stefanodemartini/flylineprofiler/(commit log)

2026-02-20 working start/stop motor
2026-02-20 Refactor UART parsing
2026-02-27 Fix: stream CSV export to avoid ESP32 freeze
    [master.ino]
2026-02-27 Fix: stream CSV export to avoid ESP32 freeze. Added
    [master.ino]
2026-03-04 Added timer, modified chart graphics
2026-04-17 Add WPF desktop app, update firmware v0.3.0, add .gitignore and Copilot instructions
    - master.ino v0.3.0: GOTOPOS, dynamic speed, scan autostop, WiFiManager
    - slave.ino v0.3.0: GOTOPOS with quadratic deceleration, UART protocol
    - app/: WPF desktop client (MVVM, WebSocket, ScottPlot placeholder)
    - .gitignore: exclude bin/obj and VS artifacts
    - .github/copilot-instructions.md: architecture and conventions docs
2026-04-17 Fix all WPF app gaps vs web UI
    Bugs fixed:
    - scan_on/scan_off commands were sent as 'scanon'/'scanoff' (firmware ignored them)
    - 'params' message: displayZero/offset not parsed or displayed; now shown in status panel
    - Existing point update did not trigger CollectionChanged; plot never refreshed (use remove+add)
    - 'scan_enabled' message: ScanReceiving state not tracked; buttons not reflecting scan state
    - 'goto_status': IsGoToActive not tracked; motor/scan/goto buttons not disabled during GOTOPOS
    Features added:
    - Load full history from HTTP /export on every WebSocket connect (batch, single plot refresh)
    - Auto-reconnect after disconnect (ReconnectSeconds from settings, cancellable on manua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
2026-04-17 fix: resolve 15 firmware bugs in master.ino and slave.ino
    master.ino:
    - FW-01: add microsecond timeouts to readCaliper() and decodeCaliperReadings()
    spin-loops — prevents infinite hang when caliper is off or disconnected
    - FW-04: addDataPoint() update path now stores EMA-smoothed diameter
    (newPoint->diameter) instead of raw value — fixes EMA state corruption
    - FW-07: goToPosition() sends targetCm+2 to slave to compensate for the
    (encoder/30)-2 coordinate offset — fixes 2 cm systematic positioning error
    - FW-08: goToPosition() early-returns when isGoToActive — prevents re-entrant
    WebSocket call from overwriting oldScanState and losing scan enable state
    - FW-09: loop() takes on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
    [master.ino, slave.ino]
2026-04-17 fix: broadcast scan_enabled:false when GOTOPOS starts
    Clients now receive a scan_enabled:false event the moment goToPosition()
    suspends scanning, making the protocol symmetric with the scan_enabled
    restore broadcast already sent on GOTOPOS completion or abort.
    [master.ino]
2026-04-17 fix: restore missing # on #include <WiFi.h>
    [master.ino]
2026-04-17 fix: increase caliper timeout from 500us to 10ms per clock phase
    The original 500 us timeout was shorter than the actual caliper clock
    half-period (many cheap calipers run at ~500 Hz = ~1 ms per phase),
    causing decodeCaliperReadings() to bail on every bit and leave
    lineDiameter permanently at 0.
    New values: 10 ms per bit phase (handles any caliper down to 50 Hz),
    500 ms for the inter-packet HIGH gap.
    [master.ino]
2026-04-17 revert: restore original caliper spin-loops (FW-01 reverted)
    Timeout-based approach was breaking caliper reads because the actual
    clock half-period of this caliper is unknown and exceeds any generic
    timeout value. The hardware watchdog (default ~1s) provides a safety
    net on disconnect. A proper fix requires ISR-driven caliper reading
    which can be addressed in a future iteration.
    [master.ino]
2026-04-17 fix: replace blocking caliper reader with interrupt-driven ISR (FW-01)
    onCaliperChange() (IRAM_ATTR, CHANGE on CALIPER_CLOCK_PIN) mirrors the
    original logic entirely in interrupt context:
    - Rising edge → record timestamp
    - Falling edge → measure HIGH duration; if >500 µs = inter-packet gap,
    commit the 24-bit word (calRawValue/calSign/calDataReady)
    and reset accumulators; then read the data bit
    readCaliper() is now non-blocking: noInterrupts() + copy latest decoded
    value from ISR state + clear calDataReady. loop() is never blocked.
    readCaliperAverage() waits for up to 2 s for N fresh ISR packets instead
    of calling the old blocking spin loop.
    This als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
    [master.ino]
2026-04-17 fix: correct caliper unit conversion from /100 to /200
    The caliper protocol encodes values in units of 0.005 mm per LSB.
    The old blocking loop accidentally skipped bit-0 (the LSB) due to
    its wait-for-rising-then-falling structure, halving the raw count.
    rawCount/2 / 100 = correct mm value.
    The ISR reads all 24 bits correctly, so dividing by 100 gave 2x the
    true measurement. Dividing by 200 restores the correct output.
    [master.ino]
2026-04-17 fix: remove redundant JS live EMA from web UI
    Firmware already applies EMA (alpha=0.1) before sending data over
    WebSocket. The JS live EMA was double-smoothing the signal, adding
    latency and masking fast diameter changes.
    Live view now uses firmware-smoothed values directly.
    Historical chart EMA slider is unaffected.
    [master.ino]
2026-04-17 fix: make GOTOPOS encoder-driven instead of open-loop step-count
    Root cause: slave used its own step counter (from boot) to decide when
    to stop during GOTOPOS. If encoder and slave step count diverged (after
    a reset command, different PULSES_PER_CM calibration, or step slippage)
    the motor would stop at the wrong physical position, independent of
    what the encoder reported.
    Two-part fix:
    1. SYNCPOS command: master sends current encoderValue to slave before
    every GOTOPOS so slave step counter = encoder value (both in sync).
    2. Encoder-based stop in master loop: master watches encoder and sends
    STOP when |floatCm - goToTargetCm| <= 0.5cm. This is the authoritative
    completion trigger. g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
    [master.ino, slave.ino]
2026-04-17 fix: reduce coasting distance when stopping from FAST mode
    At ACCEL=1500 steps/s² and FAST_HZ=12000 steps/s the deceleration
    distance was ~16 metres (48,000 steps). This caused excessive overshoot
    after a FAST stop.
    Add FAST_STOP_DECEL=24000 steps/s² applied only when stopMotion() is
    called from FAST_S or FAST_O mode. This reduces the stop distance to
    ~1 metre (3,000 steps = ~100cm). Normal ACCEL is restored immediately
    after for subsequent SCAN/GOTOPOS moves.
    [slave.ino]
2026-04-17 feat: show position label next to each segment node
    Each node now displays a small label anchored at the node point:
    142 cm
    0.880 mm
    Label uses 9pt dark-red text with a semi-transparent white
    background so it stays readable over the scan data. Labels
    update live during drag so you can see exact coordinates while
    repositioning a node.
2026-04-17 feat: live hover readout snapping to nearest scan data point
    Move cursor over the chart and the status bar shows the exact
    measurement at that position:
    142 cm | 0.880 mm
    Works in both normal and segment-draw mode. Clears when the
    mouse leaves the chart. Reads FilteredY (EMA-smoothed value)
    from the nearest MeasurementPoint by X distance.
2026-04-17 feat: make segment node labels clearly visible
    - Font 9pt → 11pt bold
    - White near-opaque background (0.93 alpha)
    - Dark-red border 1.5px + 4px padding inside box
    - 8px pixel offset (right+up) so label clears the marker dot
2026-04-17 fix: export segment nodes only, no interpolation
    CSV now contains exactly the nodes you placed — one row per node,
    sorted by position. No per-cm interpolation.
    Lunghezza cm,Diametro mm
    34,0.880
    520,0.910
    ...
2026-04-17 feat: save and load segment nodes (session persistence)
    File > Salva nodi... — saves nodes to .nodes.csv
    File > Carica nodi... — reloads a previously saved session;
    asks confirmation before replacing existing nodes.
    The file format is the same as the export CSV, so both are
    interchangeable.
2026-04-17 feat: replace menu bar with Office-style Fluent Ribbon (Fluent.Ribbon 10)
    - Add Fluent.Ribbon NuGet package
    - Window → RibbonWindow; Menu → Ribbon with Backstage (File button)
    - Tabs: Connessione | Motore | Grafico | Segmenti
    - Command buttons removed from content area; all controls in ribbon
    - Layout simplified: Stato + GOTOPOS (row 0), Chart (row 1, fills), Log (row 2)
    - AutoFitToggle_Click / ToggleDrawMode_Click updated for ToggleButton IsChecked (bool?)
2026-04-17 fix: apply Light.Blue ribbon theme via XAML resource merge
    Merge Fluent/Themes/Themes/Light.Blue.xaml in App.xaml instead
    of calling ThemeManager at runtime — avoids the missing-theme
    crash and works correctly without any code changes.
2026-04-17 fix: remove -2cm boot offset from GOTOPOS and position display
    The arbitrary -2 offset caused:
    - display showing -2 at boot / after reset (not 0)
    - GOTOPOS needing a hidden +2 compensation in the command
    Now: reset at physical start -> display shows 0 -> GOTOPOS 2400
    stops exactly 2400 cm from your defined zero. No hidden offsets.
    Changes:
    - All four (encSnap|encoderValue)/PULSES_PER_CM: removed - 2
    - goToPosition(): removed + 2.0f from GOTOPOS cmd, updated comment
    [master.ino]
2026-04-17 fix: restore -2cm caliper offset; fix reset to show 0 at line start
    The encoder wheel is physically 20mm behind the caliper, so the
    display formula caliper_cm = encoder/30 - 2 is correct and must
    be kept. The previous commit wrongly removed it.
    The real bug was in reset: setting encoderValue=0 made the display
    show -2 after reset instead of 0. Fixed by setting
    encoderValue = 2 * PULSES_PER_CM so the caliper formula yields 0.
    Workflow:
    1. Position caliper at physical line start
    2. Press Reset -> display shows 0
    3. GOTOPOS 2400 -> caliper stops at exactly 2400 cm
    [master.ino]
2026-04-17 feat: separate Reset lunghezza and Cancella grafico
    Firmware:
    - New resetpos command: resets encoder to 0 (display shows 0)
    without clearing measurement data
    WPF ribbon:
    - Motore > Calibrazione: add Reset lunghezza (sends resetpos)
    - Grafico > Vista: add Cancella grafico (clears local chart data only)
    - Reset dati remains as the combined operation (position + data)
    [master.ino]
2026-04-17 refactor: single Azzera tutto button (zeros position + clears graph)
    Remove separate Reset lunghezza / Cancella grafico buttons.
    Single button in Motore > Calibrazione does both: sends reset
    to firmware (zeros encoder) and clears local chart data.
2026-04-17 feat: move smoothing to app, remove EMA from firmware
    - Remove EMA from addDataPoint — broadcasts raw compensated diameter
    - Remove emaStore/emaStoreInit globals
    WPF app:
    - SmoothingEnabled property in MainViewModel (default true)
    - AddLivePoint applies EMA only when SmoothingEnabled; resets EMA
    state when toggled so next point seeds a fresh filter
    - Grafico > Vista: Smoothing EMA toggle button (default ON)
    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
    [master.ino]
2026-04-17 fix: catch WebSocket disconnect exceptions in ReceiveLoopAsync
    ESP32 closes the WebSocket without the proper close handshake.
    Without catching the exception the fire-and-forget task becomes
    an unobserved exception and crashes the app via the GC finalizer.
    Catch WebSocketException, OperationCanceledException and IOException;
    Disconnected event is always fired in the finally block.
2026-05-03 feat: encoder-fed position for GOTOPOS + caliper median filter + live EMA
    - Remove SYNCPOS one-shot sync; master now streams POS:<steps> every 100ms
    during GOTOPOS so slave uses wheel encoder as sole position source
    - Slave getDistanceToGo() and checkPositionReached() use encoderFedPos
    instead of stepper->getCurrentPosition()
    - POS: updates dropped in motorQueueTx if a real command is pending
    - Add readCaliperMedian(5): collects 5 packets, returns median value,
    replacing single readCaliperDisplay() in scan loop — rejects spikes
    - JS addDataPoint() and loadHistoryFromExport() now apply smoothEMA()
    with the slider alpha before pushing to chart (live data treated same
    as imported da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
2026-05-21 v0.4.1: fix scan state desync on client connect
    Send scanEnabled state to every client on WebSocket connect so the
    Ricezione ON/OFF button always reflects the real firmware state.
    Prevents length display from updating when button shows Ricezione OFF
    after a page reload or reconnect while scan was active.
    [master.ino, slave.ino]
2026-05-22 slave v0.4.2: fix GOTOPOS motor not moving + overshoot detection
    [slave.ino]
2026-05-22 Fix GOTOPOS overshoot: physics-correct sqrt deceleration + initial encoder sync
    - slave v0.4.3: replace quadratic curve with sqrt(2*GOTOPOS_ACCEL*d*STEPS_PER_ENC) profile.
    The sqrt curve guarantees the motor can always stop exactly at target:
    at d=5 enc -> v=1225 Hz -> stopping distance=5 enc (perfect landing).
    - slave: add GOTOPOS_ACCEL=6000 Hz/s (4x SCAN) and STEPS_PER_ENC=25 constants.
    - slave: GOTOPOS handler now parses initial encoder position (4th field in command)
    and starts motor at calculateDynamicSpeed(initialDist) instead of FAST_HZ.
    This eliminates overshoot for short GOTOPOS moves (<83 cm) entirely.
    - slave: simplify checkPositionReached() stop condition to distanceToGo<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
    [master.ino, slave.ino]
2026-05-22 slave v0.4.4: simplify GOTOPOS to two-phase fastslowforceStop
    Replace physics sqrt curve with a simple two-phase approach:
    - Phase 1: run at FAST_HZ while distance > SLOW_ZONE_ENC (500 enc, ~16 cm)
    - Phase 2: drop to MIN_SPEED_HZ (300 Hz, ~0.5 cm/s) inside the slow zone
    - At target (distanceToGo <= 5): call forceStop() for instant stop with zero coast
    forceStop() is safe at 300 Hz because the motor has negligible kinetic energy.
    Removes GOTOPOS_ACCEL and STEPS_PER_ENC constants (no longer needed).
    [slave.ino]
2026-05-22 slave v0.4.5: fix slow-zone transition use FAST_STOP_DECEL for FASTSLOW brake
    Root cause of v0.4.4 failure: ACCEL=1500 Hz/s takes ~62 cm to brake from
    FAST_HZ(12000) to MIN_SPEED_HZ(300). The 500 enc slow zone was only ~16 cm,
    so the motor was still going ~9000 Hz when it hit the target same overshoot.
    Fix: when entering the slow zone, setAcceleration(FAST_STOP_DECEL=24000) before
    setSpeedInHz(MIN_SPEED_HZ). At 24000 Hz/s the brake takes ~120 enc (~4 cm),
    leaving ~80 enc of genuine crawl before forceStop() fires at 5 enc.
    Also reduce SLOW_ZONE_ENC from 500 to 200 (200 enc > 120 enc brake dist = safe margin).
    Restore ACCEL after forceStop() for subsequent SCAN moves.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
    [slave.ino]
2026-05-22 slave v0.4.6: fix stopMotion() for GOTOPOS use forceStop() not stopMove()
    Root cause of all GOTOPOS overshoot: stopMotion() called stopMove() then
    immediately setAcceleration(ACCEL=1500). FastAccelStepper applies setAcceleration()
    to the ONGOING deceleration, overriding any FAST_STOP_DECEL set earlier.
    Result: motor always decelerates at 1500 Hz/s from 12000 Hz = 64 cm of coast.
    Fix: for GOTOPOS mode, use forceStop() which stops the motor with no decel ramp.
    Step loss is acceptable because the encoder (not step counter) is the position
    reference. The slow-zone logic (FAST_STOP_DECEL + MIN_SPEED_HZ) still runs and
    will reduce speed before the stop, making forceStop() mechanically gentle.
    C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
    [slave.ino]
2026-05-22 slave v0.4.7: GOTOPOS linear speed ramp over last 33 cm
    Replace two-phase (fast/slow) with a smooth linear ramp:
    v = MIN_SPEED_HZ + (FAST_HZ - MIN_SPEED_HZ) * (dist / SLOW_ZONE_ENC)
    dist=1000 enc 12000 Hz, dist=500 6150 Hz, dist=0 300 Hz
    Final stop is still forceStop() at 5 enc (v0.4.6 fix unchanged).
    Add GOTOPOS_ACCEL=6000 Hz/s: required for motor to track the ramp;
    ACCEL=1500 takes 8s to go 12000300, motor would still be fast at stop.
    GOTOPOS_ACCEL switches in when entering the slow zone and stays until forceStop().
    ACCEL restored by stopMotion() for subsequent SCAN moves.
    [slave.ino]
2026-05-22 slave v0.4.8: step-counter ramp for smooth GOTOPOS decel + 70% max speed
    Problem: speed ramp was driven by POS updates (every 100ms) at 8400 Hz
    the motor moves 336 enc between updates, so ramp changes were invisible.
    Fix: drive the speed ramp from the step counter (updates every loop ~100kHz).
    - startStepPos recorded at GOTOPOS start
    - updateDynamicSpeed() calculates remaining dist from stepsElapsed/STEPS_PER_ENC
    - Encoder (POS) overrides the estimate when available for accuracy
    - calculateDynamicSpeed() uses linear ramp GOTOPOS_MAX_HZMIN_SPEED_HZ over SLOW_ZONE_ENC=1000 enc
    - Ramp zone entry: setAcceleration(GOTOPOS_ACCEL=6000) so motor tracks the ramp
    Also: GOTOPOS_MAX_HZ = 70% of FAST_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
    [slave.ino]
2026-05-22 slave v0.4.9: millis-based speed ramp reliable smooth decel for GOTOPOS
    Problem: getCurrentPosition() in FastAccelStepper runForward() mode is
    unreliable on ESP32 step counter may not update as expected, causing
    the ramp to never fire.
    Fix: replace step counter with millis()-based distance estimate.
    - At GOTOPOS start: record gotoDistAtSync=initialDist, gotoSyncMs=now
    - Every 25ms in loop: estimate remainingDist = gotoDistAtSync
    - (currentDynamicSpeed / STEPS_PER_ENC) * elapsed_ms / 1000
    - On each POS update from master: resync gotoDistAtSync and gotoSyncMs
    to the fresh encoder reading (keeps estimate accurate)
    - calculateDynamicSpeed(): linear GOTOPOS_MAX_HZ MIN_SPEED_HZ over 1000 e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
    [slave.ino]
2026-05-22 slave v0.4.9: fix compile errors (max type mismatch + stale step-counter refs)
    [slave.ino]
2026-05-22 slave v0.5.0: use stepper->move() for GOTOPOS let FastAccelStepper handle decel
    All previous approaches used setSpeedInHz() to manually ramp speed, which
    proved unreliable on ESP32 (step counter wrong, millis extrapolation imprecise).
    New approach: stepper->move(steps) gives FastAccelStepper a finite step target.
    Its internal motion planner produces a perfect trapezoidal profile
    (accelerate cruise decelerate) with no manual ramp code needed.
    steps = initialDist * STEPS_PER_ENC * 0.85 so the motor is already decelerating
    well before the encoder target. forceStop() in checkPositionReached() provides
    the precise stop at encoder target (step count accuracy irrelevant).
    Removes: calculateDy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
    [slave.ino]
2026-05-22 master v0.4.3: GOTOPOS vertical line overlay on chart
    During GOTOPOS, draws a red dashed vertical line on the chart at the
    current encoder position (current_cm from goto_progress WebSocket messages).
    Uses a custom Chart.js plugin (gotoposLinePlugin) registered inline
    no annotation CDN needed. Works correctly with zoom/pan.
    Line shows position label (e.g. '52.3 cm') near the top.
    Line is cleared (gotoPosX=null) when GOTOPOS completes or is interrupted.
    [master.ino]
2026-05-22 slave: fix GOTOPOS stops too early increase step factor 85%120%
    With 0.85 the move() command exhausted all steps before the encoder
    reached the target, so the motor stopped early and forceStop() never
    fired. With 1.20 the motor is guaranteed to still be in its decel
    phase when checkPositionReached() fires at the encoder target.
    [slave.ino]
2026-05-22 slave: GOTOPOS decel zone physics-based step calculation
    Instead of a fixed factor, compute deceleration distance from v²/(2a):
    decelSteps = GOTOPOS_MAX_HZ² / (2 * GOTOPOS_ACCEL) = ~5880 steps (~7.8cm)
    Move endpoint = encoder_target_steps + decelSteps/2 (halfway through decel).
    This guarantees the motor is already decelerating when the encoder target
    is hit, for ANY move length. forceStop() then gives the precise stop.
    [slave.ino]
2026-05-22 slave: reduce GOTOPOS_ACCEL 6000->1500 for ~31cm decel zone
    At 8400 Hz with ACCEL=1500 Hz/s: decel distance = v²/2a = ~23520 steps = ~31cm.
    Motor starts decelerating ~15cm before the encoder target.
    forceStop() fires at encoder target (motor already at reduced speed).
2026-05-22 slave: reduce GOTOPOS_ACCEL 1500->800 decel starts ~30cm before target
    At 8400 Hz with ACCEL=800 Hz/s: decel distance = v²/2a = ~44100 steps = ~58cm.
    Motor starts decelerating ~30cm before the encoder target.
2026-05-22 master: keep GOTOPOS vertical line visible after position reached
    Line now persists on chart after GOTOPOS completes. Only cleared if
    movement is interrupted or a new GOTOPOS starts.
2026-05-22 master v0.4.4: fix encoder init -2 and vertical line position lag
    1. encoderValue init 0->2*PULSES_PER_CM: display now shows 0cm on startup
    instead of -2cm, without needing to press the zero button first.
    2. goto_status now includes final_cm (actual encoder position at stop).
    JS snaps gotoPosX to final_cm on completion, so the vertical line
    lands at the real stop position, not the last goto_progress sample.
    [master.ino]
2026-05-27 fix(gotopos): two-phase precise positioning + non-blocking caliper buffer
    master v0.4.5 / slave v0.5.1
    ## master/master.ino
    - Non-blocking caliper rolling buffer (CAL_BUF_SIZE=7): pumpCaliper() feeds
    a circular buffer every main-loop iteration; readCaliperBufferedMedian()
    takes the median instantly at each cm trigger eliminates the ~385 ms
    blocking readCaliperMedian(5) that caused up to 30 cm steps to be missed.
    - GOTOPOS overshoot safety guard: removed preemptive STOP at 0.5 cm (was
    firing forceStop at ~775 Hz and stopping short of target); replaced with
    a safety-only guard that sends STOP only if encoder overshoots final
    target by > 1 cm. goToFwd saved as global for the direc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
    [master.ino, slave.ino]
2026-05-27 feat(ui): mirrored profile chart for full cross-section view
    master v0.4.6
    Adds a symmetric profile view: the diameter scan line is now mirrored
    below the Y=0 axis, giving a true cross-section appearance of the fly line
    instead of just the upper half.
    - Chart Y axis is now symmetric (maxY +maxY); ticks display absolute
    values (e.g. '1.0 mm') so the axis reads naturally on both halves.
    - Live-scan dataset (index 0) uses fill: '+1' to shade the area between
    the top profile and its mirror dataset (index 1), creating the filled
    oval/lens cross-section silhouette.
    - mirrorData(data) helper maps {x,y} {x,y}.
    - Mirror datasets are labelled '__mirror__<name>': filtered out of the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
2026-05-27 feat(export): multi-column CSV export for all visible datasets
    master v0.4.7
    - Renamed export button into two separate buttons:
    'Esporta Scansione' - live scan only (unchanged behaviour)
    'Esporta Tutti i Dataset' - all visible datasets in aligned columns
    - exportCurrentScan(): exports raw dataPoints (positive values, no mirror).
    - exportAllDatasets(): builds a single CSV with one column per visible
    dataset (live scan + uploaded). Rows are keyed on the union of all
    x positions across sources, sorted ascending. Cells are blank where a
    dataset has no point at a given position. Filename includes timestamp.
    - triggerDownload(): shared helper extracted from both export func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
2026-05-27 master v0.4.8: encoder-diameter position correction
    The encoder wheel (flat, circumference 20 cm) over-counts actual line
    travel when the line diameter is non-zero because it rolls on a larger
    effective radius than at d=0.
    Fix: accumulate actualPositionCm using the corrected step size:
    corrFactor = (20 - pi * d_mm/10) / 20 (clamped [0.5, 1.0])
    actualPositionCm += corrFactor at every encoder-cm tick
    DataPoint now stores both:
    - cm: corrected actual position (used for chart X axis)
    - encoderCm: raw encoder cm (used by GOTOPOS slave command)
    goToPosition() searches the DataPoint list for the nearest actual-cm
    match and uses its encoderCm as the slave target, so GOTOPOS phys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
    [master.ino]
2026-05-27 master v0.4.9: fix encoder-diameter correction coefficient
    The v0.4.8 formula used the full diameter d in the effective circumference
    model (C_eff = 20 - pi*d/10), which over-corrected: display 500 cm when
    actual was 505.7 cm (direction reversed vs v0.4.7).
    Root cause: the physical sinking model gives C_eff = 20 - pi*r/10 where
    r = d/2 (the line radius), not the full diameter. This halves the correction:
    corrFactor = (20 - pi * d_mm / 20) / 20
    Verification:
    d=2.36mm (head): corrFactor=0.981 -> 100 enc -> 98.1 cm (physical 96.3)
    d=0.65mm (running): corrFactor=0.995 -> 500 enc -> 497 cm (physical 495.5)
    [master.ino]
2026-05-27 master v0.4.10: fix mirrored chart scale (diameter not doubled)
    The mirror dataset reflected y -y, so the total visual height was
    2 × diameter instead of 1 × diameter, making the line look twice as thick.
    Fix: add toHalfY() helper that maps diameter radius (d/2) before
    passing data to chart datasets. mirrorData() then reflects radius -radius,
    giving a total profile height equal to the actual line diameter.
    - toHalfY() applied in addDataPoint, redrawLiveSmoothing, loadHistoryFromExport,
    addDatasetToChart (both top and mirror datasets)
    - fitToData: maxY = maxDiameter / 2 (chart y-axis now in radius units)
    - Tooltip: shows abs(y) * 2 so the hover still displays the real diamet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
    [master.ino]
2026-05-27 master v0.4.11: live diameter dimension annotation on chart
    While scan is active, a technical dimension annotation (quota) is drawn
    at the latest scan point:
    - two horizontal tick marks spanning +-radius on the profile
    - vertical dimension line with inward-pointing arrowheads at both ends
    - 'O X.XX mm' label centered between the arrows
    Implemented as diameterQuotaPlugin (custom Chart.js afterDraw hook),
    registered globally alongside gotoposLinePlugin. Annotation auto-flips
    left if the latest point is near the right chart edge. Disappears when
    scanning is stopped.
    [master.ino]
2026-05-27 master v0.4.12: replace tooltip box with canvas dimension annotation
    Hover over any chart point now shows a technical dimension annotation
    identical in style to the live scan quota (v0.4.11):
    - 'X.X cm' label above the top tick
    - inward arrows spanning +-radius of the profile
    - 'O X.XX mm' diameter label centered between the arrows
    Implemented as hoverQuotaPlugin (afterDraw, reads chart.tooltip._active).
    Default tooltip box disabled (enabled: false). Annotation auto-flips
    left when the hovered point is near the right chart edge. Mirror dataset
    elements are filtered out so only the real profile drives the annotation.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
    [master.ino]
2026-05-27 master v0.4.13: export chart as PNG
    Added 'Esporta PNG' button that calls chart.toBase64Image() and triggers
    a browser download of the current chart view as a PNG file named
    profilo_<timestamp>.png. Works with any visible datasets, zoom level,
    and includes all custom canvas plugins (quota annotation, goto line, etc.).
2026-05-27 master v0.4.14: fix hover annotation plugin (use afterEvent API)
    v0.4.12 used chart.tooltip._active to detect the hovered point, which
    is an internal property that may be unpopulated when tooltip.enabled=false.
    This caused the UI to not render correctly.
    Fix: rewrite hoverQuotaPlugin to use the afterEvent hook with
    chart.getElementsAtEventForMode() the stable public API. The plugin
    captures the hovered DataPoint on mousemove, clears on mouseout, and
    draws the dimension annotation in afterDraw.
    Also simplified tooltip config (enabled:false, mode:nearest).
    [master.ino]
2026-05-27 master v0.4.15: fix blank page - switch to chunked sendContent
    [master.ino]
2026-05-27 app: align desktop UI with web UI v0.4.15
    - RefreshPlot: symmetric mirrored profile (top +radius / bottom -radius)
    with centre axis line, matching web UI chart layout
    - RefreshPlot: live scan annotation (Ø X.XX mm @ X.X cm label)
    at the last received point when ScanReceiving is true
    - PropertyChanged: RefreshPlot when ScanReceiving changes so
    annotation appears/disappears immediately
    - UpdateHoverCoords: format changed to 'Ø X.XXX mm @ X.X cm'
    - ExportCsv: 2-column format 'Lunghezza cm,Diametro mm'
    (was 3-column with Raw and Filtered)
    - LoadImportedSeries: auto-detect column layout from header;
    handles bare 2-col, 4-col Dataset format, and multi-dataset CSVs
    - Imported series a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
2026-05-27 master v0.4.16: gradient fill (sfumatura) on profile chart
    Add gradientFillPlugin that runs in beforeDraw on every render cycle.
    For each top-profile dataset (fill:'+1', non-mirror), builds a vertical
    CanvasGradient spanning the full y-axis range with 7 colour stops:
    0% rgba(R,G,B, 0.72) dark outer edge (top)
    28% rgba(R,G,B, 0.44) mid-tone body
    45% rgba(255,255,255,0.18) near-centre brightening
    50% rgba(255,255,255,0.30) centre gloss (specular highlight)
    55% rgba(255,255,255,0.18) near-centre brightening
    72% rgba(R,G,B, 0.44) mid-tone body
    100% rgba(R,G,B, 0.72) dark outer edge (bottom)
    Creates the visual effect of a solid cylindrical cross-section:
    dark edg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
2026-05-27 master v0.4.17: fix gradient fill manual polygon using real pixel coords
    Previous approach (beforeDraw + ds.backgroundColor = gradient) failed
    because Chart.js's core filler plugin runs before user plugins in
    beforeDatasetsDraw, so the flat static fill was drawn on top of
    or instead of the gradient.
    New approach:
    - gradientFillPlugin now runs in beforeDatasetsDraw and manually draws
    a gradient-filled polygon by reading actual pixel coordinates from
    chart.getDatasetMeta(i).data (PointElement.x / .y) which are fully
    computed at this hook stage
    - Gradient is anchored to the actual pixel extent of the data band
    (yBandTop/yBandBot from real points), not the full y-axis range,
    so the s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
    [master.ino]
2026-05-29 app: full UI redesign dark instrument panel theme
    Remove Fluent Ribbon entirely (Window base class, no more RibbonWindow).
    Replace complex 4-tab ribbon + hero banner with a clean dark layout:
    Header bar (52px)
    - App title with accent LED indicator
    - Connection status + Connect/Disconnect buttons
    Toolbar (52px, scrollable)
    - All actions visible at once, grouped by function with separators:
    Scan | Motor | Calibration | Chart view | Data import/export | Segments
    Metrics strip (72px, scrollable cards)
    - Connessione, Motore, Lunghezza, Diametro, Display, Velocita, Punti,
    Zero display, Offset, GoTo each as a compact dark card
    Chart area (fills all remaining space)
    - Clean d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
2026-05-29 app: remove emoji from button labels (WPF can't render color emoji)
    Replace with plain text labels.
    Simple Unicode symbols ( ) are fine in Segoe UI.
2026-05-29 app: rewrite XAML with pure ASCII English labels, no Unicode symbols
    Previous file had UTF-8 multi-byte chars (arrows, symbols) that WPF
    rendered as garbage. Rewrote entire XAML using only ASCII characters.
    All button labels translated to English:
    Connetti/Disconnetti -> Connect/Disconnect
    SCAN/STOP/RX ON/RX OFF unchanged
    FAST/GOTO/Status
    Set Zero/Set Offset/Reset Offset/Read Raw
    Fit/Auto-Fit/Clear Chart
    Import CSV/Export CSV/Export PNG/Clear Imported
    Draw Segments/Undo Node/Clear Nodes/Save Nodes/Load Nodes/Export Seg. CSV
    Settings
    Metric cards: Connection/Motor/Length/Diameter/Display/Speed/Points/
    Display Zero/Offset/GoTo Status
    Log expander: Diagnostic Log/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
2026-05-29 app: fly line Project tool segment geometry and volume calculator
    New features:
    - ProjectSegment model: per-segment shape (Cylinder/Frustum), volume
    (mm3), taper rate (mm/m) computed from adjacent node pairs.
    - DesignNode model: INPC wrapper for the editable nodes DataGrid.
    - Nodes now store full DIAMETER in mm (was chart-radius bug fixed).
    Chart renders design at diameter/2 (radius) to align with scan profile.
    - Design overlay: filled gradient band (same sfumatura as scan) + labels
    showing Diameter mm + position cm above each node marker.
    - RefreshSegmentTable(): builds ProjectSegments from sorted nodes and
    keeps DesignNodes DataGrid in sync with the canonical _segmentNodes list.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
2026-05-29 app: fix CSV import chart scale explicit AutoScale after import
    ScottPlot 5 requires Refresh() to be called after AutoScale() for
    the new axis limits to actually render. Without this extra call,
    the chart kept its previous (often default) scale and the imported
    fly-line profile appeared as a tiny ~0.1mm band instead of filling
    the view at the correct radius range.
2026-05-29 app: fix FitAfterRefresh always runs + add Fit View button
    Remove the _autoFitEnabled guard from FitAfterRefresh() so that explicit
    user operations (CSV import, add/drag node, load nodes) always force an
    AutoScale+Refresh pass regardless of the AutoFit setting.
    The AutoFit setting now only gates the live-scan autoscale inside
    RefreshPlot() itself, which is the intended UX.
    Also add a 'Fit View' toolbar button that always re-fits the chart.
2026-05-29 app: add project system (.flp files)
    Projects are stored as JSON .flp files in:
    Documents\FlyLineProfiler\Projects\
    A project persists:
    - Scan points acquired from the ESP32
    - Imported comparison CSV series (data embedded, no external dependency)
    - Design nodes (taper profile overlay)
    New / Open / Save / Save As buttons in the header bar.
    Window title shows project name + '*' when there are unsaved changes.
    Closing the app with unsaved changes prompts to save or discard.
    All state-modifying operations (import CSV, scan data, add/move/remove nodes,
    clear chart, load nodes) mark the project dirty.
2026-05-29 app: add Close Project button
    Clears all project state and resets to Untitled.
    Prompts to save if there are unsaved changes.
2026-05-29 v0.4.22: PCNT encoder, chart fixes, and WPF app improvements
    Master firmware (v0.4.22):
    - Fixed chart display: actualCm now directly uses encoder position (no odometer)
    - NaN/Inf guard on caliper JSON broadcast to prevent silent parse failures
    - PCNT hardware encoder: 0.28% accuracy (vs 5% before ISR interference fix)
    - Verified scan loop accuracy at 214cm actual travel
    WPF Desktop App:
    - Fixed imported CSV display in design mode (was hidden due to _showScanLayer gate)
    - Added CONTEXT.md with comprehensive system documentation
    - Full stack: .NET 8 WPF, ScottPlot 5.0.52, physics engine for sinking speed
    - Project save/load (.flp JSON), segment table, design node editing
    CONTEXT.md:
    - Comple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
    [encoder_test.ino, master.ino, slave.ino]
2026-06-08 Add colour sections feature with PDF legend + all bug fixes
    - Colour sections: define coloured bands along the line, stored in project model
    - Live chart: flat polygon fills (no Lambert shading) for vivid colour display
    - PDF chart: same flat polygon approach so bands are clearly visible in export
    - PDF legend: row of coloured swatches + position ranges below chart image
    - Colour note field: free-text note rendered in amber block in PDF
    - Profile colour persistence: saved/loaded per project (DesignLineColorHex)
    - Embedded logo asset: RazorBladeFlyLines.jpg as assembly resource (single-file deploy)
    - Cross-thread fix: PropertyChanged marshalled via Dispatcher.InvokeAsync
    - Startup flash fix: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
2026-06-09 Always show section label on chart: S1/S2/… fallback when Label is blank
    Section labels now always appear above the coloured band. If the Label
    field is filled in, that text is used; otherwise the section gets an
    automatic name S1, S2, S3… based on its position in the list.
2026-06-09 Fit PDF to one page: tighter spacing, smaller chart, compact legend row
    - col.Spacing 7→4, margin 18→14
    - Chart render height 420→300px
    - Notes block padding 6→4
    - Colour legend: horizontal inline row (swatch + hex + label), no stacked column
    - Table header PaddingVertical 3→2, row PaddingVertical 1→0
    - Logo column 150→110, title font 18→16pt
2026-06-09 Add 18% top padding to Y axis so segment labels don't clip at top border
2026-06-10 Add About dialog, fix node drawing, hover measurements, .flp file association
    - About dialog with version/author/copyright (? button in header)
    - Fix: AutoScale collapsed X range after first nodes, blocking new node placement (EnsureWideDrawingView)
    - Hover measurement: segment name + design/scan diameter in status bar and on-chart annotation
    - Open .flp passed on command line (double-click file association)
2026-06-10 Add project overlay comparison, multi-step undo, drag nodes without draw mode
    - Overlay Project button: load another .flp as comparison series (design + scan), semi-transparent silhouette rendering
    - Hover readout includes overlay diameters at cursor
    - Full undo system (100 snapshots): add/move/delete/edit/reverse/clear, Undo button + Ctrl+Z
    - Node dragging works in design mode without enabling Draw Segments
2026-06-12 Add CoM/Rg classification, visual colour picker, base colour legend, Core field
    - Centre of mass + radius of gyration computed from design segments, with
    classification and full natural-language taper description (live tooltip + PDF)
    - Visual colour picker (WinForms ColorDialog) for line and section colours
    - PDF colour legend now always includes the base line colour
    - Core material field: editable dropdown, saved in .flp, printed in PDF spec row
2026-06-12 PDF: true label collision avoidance, no spec row wrapping
    - Node labels placed via bounding-box collision detection over alternating
    below/above slots; manually dragged positions only honoured when they
    do not collide with already-placed labels
    - Chart Y axis sized to the outermost label instead of fixed padding
    - Spec row: smaller value font, tighter length/CoM strings, column spacing
2026-06-12 Add laser mark field with tip/end positions; smaller PDF segment labels
    - Laser mark text + optional positions (mm from tip / mm from rear end),
    saved in the project and printed as a blue badge in the PDF next to the
    colour note
    - S1/S2 segment labels in the PDF chart reduced from 15pt to 11pt
2026-06-13 Add Clear Scan button to discard scan data for a fresh scan
    Clears only the acquired scan points (no device command); design nodes,
    segments, colours and settings are kept. Confirmation prompt prevents
    wiping a scan mid-acquisition. Distinct from Clear Chart, which also
    sends a device reset.
2026-06-15 Add Clear Scan button to the Design Mode toolbar too
    Lets the scan be discarded and re-run without leaving Design Mode;
    reuses the same ClearScan_Click handler as the scan toolbar.
2026-06-19 PDF: higher-res chart, bigger labels, rgb colour values in legend
    - Chart rendered at 3200×600 px (was 1600×300) for sharper print quality
    - Node labels scaled to 24pt and segment labels (S1/S2…) to 22pt to match
    the doubled resolution; collision-detection box estimator updated to match
    - Colour legend entries now show rgb(r, g, b) below the hex code
    - Preserve pan/zoom when placing design nodes (RefreshPlotPreservingView)
    - Hover status bar shows Δ% difference between scan and design diameter
2026-06-19 Fix three critical bugs: AFFTA div/zero, zero-diameter node, dialog cleanup
    - ComputeAfftaBadge: guard segLen <= 0 before computing frac = usedLen/segLen;
    two nodes at the same X position produced NaN that silently corrupted the badge
    - Node placement: clamp diameter to 0.001 mm minimum so clicking the centerline
    (Y=0) never creates a zero-diameter node that causes NaN in physics calculations
    - ShowNodeEditDialog: wrap ShowDialog() in try/finally { win.Close() } so the
    window and its lambda closures are released deterministically rather than
    waiting for GC
2026-06-19 Fix risk items: undo ring buffer, label remap, temp feedback, version, PDF cleanup
    - Undo history changed from Stack to List ring buffer: when the 100-step cap is
    reached the OLDEST snapshot is now dropped (was: new snapshots were silently
    discarded, meaning the most recent changes could not be undone)
    - PDF node label offsets are now remapped when a node's X position changes via
    drag or double-click edit, so manually positioned labels follow the node
    instead of being silently orphaned
    - WaterTempC setter now shows a status-bar message when the input is outside
    0–40°C and gets clamped, so the user knows why the box value changed
    - FlyLineProject gains a Version field (set to 1 o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
2026-06-19 Add density-from-weight tool: back-calculate ρ = m / V from a measured mass
    Opens a dialog from the '⚖ From weight…' button next to the density
    controls. User selects the scope (whole line, head segments, or a custom
    subset), enters the weighed mass in grams, and the dialog live-displays
    the calculated density. On Apply, whole-line scope sets SharedDensity;
    partial scope sets per-segment SpecWeightGCm3 and switches to
    per-segment mode.
2026-06-19 Add Open Recent Files feature
    RecentFilesService persists up to 10 paths in %AppData%\FlyLineProfiler\recent.json.
    A 'Recent ▾' button next to Open opens a popup listing the files (name
    bold, full path muted). Clicking an entry opens it; missing files show
    a warning and are removed from the list. 'Clear history' wipes the list.
    Paths are recorded on every open and save.
2026-06-19 Fix compensation physics and Sink Map for compensated profiles
    SinkingSpeedCalc: slice granularity 2cm→1cm for finer resolution;
    bisection upper bracket made dynamic (max(30mm, 6×dOrig)) so very
    thick or very thin slices are always bracketed correctly.
    Sink Map now dispatches between two modes:
    - Comp Profile OFF: original relative speed map (blue=slowest section,
    red=fastest), unchanged behaviour.
    - Comp Profile ON: absolute map anchored at the target speed.
    Green (t=0.5) = exactly on target; blue = slower; red = faster.
    A correctly compensated line shows solid uniform green, making the
    quality of compensation immediately visible. Legend labels the five
    reference speeds around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
2026-06-19 Comp. Profile: speed-confirmation overlay + toggleable density map
    - SinkingToolsPanel always visible regardless of Floating/Sinking flag
    - Compensated staircase now coloured by sink speed using the same
    min/max scale as the uncompensated Sink Map — uniform colour across
    all slices is the visual confirmation that compensation worked
    - Sink Map toggle (while Comp. Profile ON) adds a semi-transparent
    density overlay (blue=low, red=high) on top of the speed colour
    - Legend shows 4-stop original speed scale + ★ target speed marker;
    density legend appears only when density overlay is active
    - Added ComputeOriginalSpeedRange() helper; removed the old
    absolute-scale RenderCompensatedS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
2026-06-19 Add Comp. View mode and density legend for PDF production worksheet
    - New 'Comp. View' toggle renders the compensated profile in the same
    visual style as the normal design profile (smooth taper per segment,
    not the 1cm staircase). The original design fades to a ghost.
    - When Comp. View is active, Export PDF uses the compensated node
    geometry so the production worksheet shows the compensated shape with
    correct diameter labels and segment markers.
    - PDF gains two new sections when Comp. View is active at export time:
    · A green note row stating the target sink speed and compensation rule
    · A density legend strip (similar to colour legend): one swatch per
    compensated segment, c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
2026-06-19 Add density gradient view; hide sinking controls for floating lines
    - Comp. View + Sink Map ON: renders the compensated profile with each 1cm
    slice filled by the density colour ramp (blue→green→red) and a tapered
    trapezoid shape for smooth visual transitions; same gradient exported in
    PDF when both toggles are active
    - Comp. View + Sink Map OFF: unchanged clean design-style view
    - UpdateLineTypeUI: SinkingToolsPanel is hidden when _isSinking=false,
    restoring the intended floating-line behaviour
2026-06-19 Comp come progetto derivato: gradiente densità sempre attivo, tabella comp
    - Quando la compensazione è calcolata, il grafico passa automaticamente
    alla vista compensata con gradiente densità (blu→verde→rosso per densità
    crescente) senza bisogno di toggle manuali
    - Pulsante "Non compensato" sostituisce Comp.Profile e Comp.View; mostra
    il profilo originale con mappa velocità affondamento sempre attiva
    - Tabella: in modalità comp le colonne originali (Start/End Ø, Sp.W.,
    Sink, Shape, Taper) vengono nascoste e compaiono le colonne comp
    (Comp.Start/End Ø, ρ Inizio, ρ Fine, Comp.Sink)
    - ProjectSegment: aggiunto CompStartDensityText e CompEndDensityText
    (densità richiesta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
2026-06-19 Fix: pannello sinking visibile per nuovi progetti senza densità
    Il pannello veniva nascosto di default perché _isSinking parte da false.
    Ora si nasconde solo quando la densità è impostata E la fisica conferma
    che la linea galleggia — altrimenti rimane visibile.
2026-06-19 Profilo compensato: shading Lambert per slice di densità
    Ogni fetta da 1cm ora usa DrawLineFill(solid:true) invece di un
    trapezoid piatto — stesso shading cilindrico 3D del profilo normale,
    con il colore che cambia orizzontalmente in base alla densità richiesta.
2026-06-19 Fix: tabella torna all'originale con 'Non compensato'; label nodi non doppie
    - UpdateCompModeUI ora usa _inCompMode && !_showOriginalProfile: quando
    si preme 'Non compensato' le colonne originali tornano visibili
    - ShowOriginalProfile_Click chiama UpdateCompModeUI prima di RefreshPlot
    - Label nodi compensati: deduplicazione dei punti di GetCompNodes (soglia
    0.5 cm) prima di disegnare marker e testo, eliminando le label doppie
    ai confini di segmento
2026-06-19 PDF: quantize density to max 4 materials; reduce chart label font size
    In compensated-profile PDF export:
    - K-means 1D clusters all slice densities into ≤4 representative values
    so the chart shows 4 discrete colour bands matching real materials.
    - PDF legend redesigned: a material key (Mat 1–4 with colour swatches
    and g/cm³ values) plus a per-segment row showing the material
    assignment, diameter range, and position.
    - Node and segment label font size reduced from 24/22 → 14 to avoid
    oversized text at the 3200×600 px render resolution.
2026-06-19 PDF comp: fix duplicate S-labels and dividers from epsilon node pairs
    GetCompNodes() produces two nodes per interior segment boundary (epsilon
    trick for interpolation). The PDF was iterating directly over those
    nodes, producing ~2x segment labels (18 instead of 10).
    Fix:
    - Deduplicate comp nodes (0.5 cm threshold) into `labelNodes` for
    node labels and dividers.
    - Segment labels (S1…Sn) now iterate over ProjectSegments directly
    in comp mode, so the count always matches the original design.
2026-06-19 Compensation: auto-use max sink speed; remove manual target input
    The target sinking speed is no longer user-editable. When ⚖ Compensate
    is clicked, ComputeCompensation() recomputes all segment sink speeds and
    picks the maximum as the target — so the compensated profile always
    achieves the fastest-sinking section's speed uniformly.
    Removed from UI: "Desired sink:" text box, in/s label, cm/s class label.
    Removed handlers: CompTargetBox_LostFocus, _KeyDown, ApplyCompTarget().
2026-06-20 Comp mode: update NodesDataGrid + fix SegmentsDataGrid column switch
    NodesDataGrid (position/diameter, bottom-left):
    - In comp mode: shows compensated boundary diameters (start of each
    segment + end of last segment), read-only, ＋ Add Node hidden.
    - Restores original editable design nodes when leaving comp mode.
    SegmentsDataGrid column visibility:
    - Moved DataGridColumn.Visibility changes into Dispatcher.BeginInvoke
    (DispatcherPriority.Render) so WPF processes the layout pass after
    the current event cycle; added InvalidateMeasure()+UpdateLayout().
2026-06-21 Comp redesign: uniform density NC, variable target, density floor, NC ghost overlay, PDF comp
    - NC profile now uses a single shared material density (uniform along entire line)
    - UseSharedDensity is always true; removed per-segment density override UI
    - CompensateProfile returns 4-tuple including bool[] clamped (density floor hits)
    - Density floor at 0.94 g/cm³ — clamped slices flagged in UI and PDF warning
    - Variable sink speed slider (V_min ≤ target ≤ V_max) in SinkingToolsPanel
    - NC ghost overlay (ShowOriginalToggle, default ON) when in comp mode
    - TriggerCompRecompute() wired to all NC-change endpoints: density change,
    node drag end, node delete (mouse + keyboard), reverse, undo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
2026-06-21 UX: separate Compensate (create) from Show C (toggle); fix 0.00 diameter precision
    - 'Compensate' button creates/recomputes C profile; becomes 'Recompute C' after first compute
    - New 'Show C' ToggleButton appears only when C profile exists, toggles comp view
    - Speed slider and ShowCompToggle visible as soon as comp data exists, not tied to view mode
    - TriggerCompRecompute() now fires when comp data exists (not just when in comp view)
    - Slider ValueChanged recomputes if comp data exists regardless of view mode
    - All diameter labels in chart, hover, and status bar now use 0.00 precision
2026-06-21 PDF C export: NC/C choice dialog, density zones, correct notes, Density legend
    - Export dialog asks NC or C when comp data exists; filename suffix _NC or _C
    - Chart rendered in the selected mode for the PDF
    - Notes: 'manufactured at exact density — fixed' replaces 'adjust density'
    - Density range precision: 0.00 everywhere
    - 'Materiali' → 'Density legend'; density values shown at 0.00 g/cm³
    - 'Segmenti' → 'Density zones': position-based contiguous bands (like color
    sections) built from per-slice density runs quantized to max 4 materials;
    each band shows Mat N, density 0.00 g/cm³, and mm range
2026-06-21 PDF: Lambert cylindrical gradient on all swatches; in-app legend 0.00 precision
    - DrawLambertSwatch() helper: simulates 3D round cross-section shading via
    N vertical strips with Lambert + specular glint — applied to colour legend,
    density legend, and density zone swatches in PDF
    - In-app density legend: ρ precision corrected to 0.00 g/cm³
    - In-app continuous gradient unchanged (no quantization in chart rendering)
2026-06-21 Nozzle system: replace ColorSections with M1-M4 nozzle model + From sink speed
    - New NozzleDefinition/NozzleZone model: each nozzle = fixed (colour, density) pair;
    zones reference a nozzle by index — colour and density are inseparable
    - 4 fixed nozzle slots (M1–M4) in UI; zones DataGrid derives values from assigned nozzle
    - SyncNozzleDensitiesFromComp(): auto-populates M1–M4 with k-means quantized comp
    densities after each compensation run; preserves user-set colours
    - UpdateCompModeUI(): nozzle density column now syncs bidirectionally — shows
    quantized comp densities in C mode, reverts to _sharedDensity in NC mode
    - Legacy ColorSections migration: each unique colour maps to it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
2026-06-26 Segments table: Sink and Comp. Sink always last column on the right
    Both NC and C modes now show the sink speed column as the rightmost
    column of the table, so it's consistently in the same visual slot
    regardless of which mode is active. XAML column order, visibility
    assignment order, and RestoreSegmentsColumnOrder indices updated
    to match. Also includes PDF, dialog, and manual updates from the
    nozzle/compensation session.
2026-08-05 Fix WebSocket message reassembly and duplicate Disconnected events
    ReceiveAsync only read a single frame, silently dropping continuation
    frames for messages split across multiple WebSocket fragments. Now loops
    until EndOfMessage. Also guards Disconnected so it only fires once instead
    of from both the explicit close path and the receive loop's finally block.
2026-08-05 Refresh CONTEXT.md WPF app section, add comp design docs, ignore publish output
    CONTEXT.md's app section was ~2 months stale (predated nozzle system, NC->C
    compensation, PDF export). Documents current architecture: MainWindow.xaml.cs
    holds Design Mode logic while MainViewModel only owns the SCAN/backend side,
    nozzle M1-M4 system, compensation workflow, PDF export contents, AFFTA badge.
    Also commits the compensation design/physics notes that were untracked, and
    ignores the self-contained publish output directories (publish/,
    app/publish_test/) which are large build artifacts, not source.
2026-09-04 Add line-weight and sink-speed family generators, fork compensated profiles to sibling files
    - Generate Family…: derive AFTMA #1-14 siblings from a design by uniformly
    scaling every diameter (closed-form, always solvable) so first-30ft mass
    hits each class's grain weight; material stays unchanged.
    - Generate by Sink Speed…: derive sink-rate siblings (slider, Floating-10ips)
    from the same taper, solving diameter scale and uniform density jointly so
    every variant keeps the source's mass/AFTMA class, the way real product
    lines keep WF6F/WF6I/WF6S3/WF6S5 all "WF6".
    - Compensated (C) profiles no longer live in the same file as the NC design:
    saving while a C profile exists forks i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
2026-09-06 Redesign nozzle/zone system: dynamic material list, per-zone density with mass preservation, and self-contained compensated files
    - Nozzles grid shows only materials actually in use (1 row for a mono-material line, up to 4 only when real distinct colours/densities exist), replacing the fixed 4-row grid
    - Compensation quantizes to the smallest number of materials whose densities differ by more than 0.02 g/cm3, instead of always forcing 4
    - New feature: assign a zone its own density directly from the base line, with a mass-preservation choice (adapt diameters vs keep them) and correct per-zone sink speed
    - Compensated (C) snapshot files now store their own independent fine geometry and per-sli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
2026-09-08 Keep compensated diameters continuous, and show real applied density everywhere
    Compensation no longer corrects a slice's diameter for the material it gets
    assigned. That correction was mass-conserving but jumped wherever the
    nearest-material assignment jumped, putting a visible step exactly where two
    materials meet. Diameter now stays at the ideal continuous solve and the
    achieved sink speed absorbs the whole discretisation error instead — a larger
    speed deviation is acceptable, a diameter step is not.
    Zone materials get the same treatment: density blends across a short ramp at a
    zone edge so the mass-conserving diameter stays continuous there too, and the
    segment is split at the exact e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
2026-09-08 Sync MANUALE with the current compensation and zone behaviour
    The compensation section still described the mass-conserving diameter
    correction that was removed, and claimed a C file stores one node per material
    change — it stores full ~1cm precision, and only the table and PDF group it.
    Adds why a hard zone edge forces a diameter step at all, and the three ways
    out, with node-anchoring as the recommended one.
2026-09-08 Add task-review notes from the feature-by-feature verification pass
    One file per reviewed area — scan workflow, segment tracing, caliper
    compression, density from weight, sink-speed map and classification, family
    generation, nozzle zones, file naming, PDF export — recording how each
    actually works and what was fixed while checking it.
2026-09-08 Add a headless design path: spec in, .flp out
    LineDesignBuilder turns a compact design spec — chained tapered sections plus
    optional material zones — into a real project, and recovers the spec from an
    existing one. UI-free, so the same code serves a script or an agent and the
    files come out indistinguishable from ones drawn by hand.
    Sections chain by default: omitting startDiameterMm continues from the previous
    end, and giving one that disagrees is rejected, so a spec cannot describe a
    diameter step. A mass-preserving zone pins its edges to real design nodes
    (inserting one on the original taper where needed) and scales the diameters
    inside by sqrt(rho_base/rho_zone) — a node carries o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
2026-09-08 Count zone materials in the AFFTA class, not just where a zone splits a segment
    BuildEffectiveSegmentsForFamilySource only assigned a zone's density to segments
    the zone boundary cut through. A segment lying entirely inside a zone has no
    boundary within it, so it was passed through untouched — carrying
    SpecWeightGCm3, the design's base density, which a zone never writes to. A zone
    covering whole segments therefore contributed nothing to the mass, and both the
    AFFTA badge and the family-generation source weighed the line as if it were made
    of one material: the 3 m sink tip on STD 27g 60 went missing, 157.1 gr instead
    of 160.4 over the first 30 ft.
    The splitting loop already looks the densi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
2026-09-08 Stop a fresh session starting out dirty, and prompting on the way out
    Selecting the active nozzle raised PropertyChanged like any other change, so the
    handler marked the document dirty — and startup selects M1, which meant an
    untouched, never-opened project was already dirty before the window appeared.
    IsActive is only "which nozzle a new zone would use": UI selection, never
    written to the file, so it no longer marks anything dirty.
    Closing also checked _isDirty on its own instead of the rule ConfirmDiscardIfDirty
    already applies — an untitled project that was never saved has nothing worth
    prompting about. Together these made closing an empty session pop a save prompt
    that cannot be ans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
2026-09-08 Extract chart rendering into a shared service, add headless PDF export
    The PDF chart image and the on-screen chart used to be two independent
    implementations of the same rendering logic — a fix in one had to be found and
    fixed again in the other, which happened more than once this week. The geometry
    and colour helpers they both called (taper/material zone boundaries, the M{n}
    material tag, slice colouring, the density colour ramp, the Lambert-shaded fill)
    move to Services/ChartGeometry; MainWindow keeps calling them unqualified via a
    `using static` import, so no call site changes. NozzleZone has no colour of its
    own in the plain model — only which nozzle it uses — so the moved GetSlice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
2026-09-09 Replace the zone-density transition ramp with exact boundary matching
    A density change on a Nozzle Zone kept producing a small diameter step at the
    zone edge even after fixing the boundary value to read from the true segment
    edge instead of a slice centre — the transition ramp itself never sat exactly
    at either density right at the edge. Removed the ramp entirely: a zone now
    sits at its full nominal density end to end, and the segment immediately
    outside it is reshaped (near end takes the zone's exact mass-conserving
    value, far end stays as drawn) so the boundary is continuous by construction,
    matching the same pin-to-node technique LineDesignBuilder already uses for
    the CLI. Two different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
2026-09-14 Add length dimension callouts to the chart, bump to 1.2.0
    Adds a continuous technical-drawing-style dimension chain (45-degree
    ticks, unitless numbers with no trailing zeros) above the profile,
    covering both the on-screen chart and the PDF export via the shared
    ChartGeometry.DrawLengthDimensionChain. Fixes surfaced along the way:
    - The PDF's own Ø/position label placer could push a label above the
    profile when crowded, landing on top of the new dimension chain —
    it now only ever stacks deeper rows below.
    - FLY TIP / REEL orientation labels now sit outside the profile's own
    X range instead of extending inward over other chart elements, and
    no longer use Unicode arrow glyphs that c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
